shinyblink/ledstream/hw/bx-hub75/FPGA_PINS.md

# FPGA pins of the bx-hub75 board.
```
IO_1  -> OE
IO_2  -> CLK
IO_3  -> C
IO_4  -> A
IO_5  -> B2
IO_6  -> R2
IO_7  -> B1
IO_8  -> R1
IO_9  -> LAT
IO_10 -> D
IO_11 -> B
IO_12 -> E
IO_13 -> G2

IO_14 -> TX
IO_15 -> RX
IO_16 -> MOSI
IO_17 -> SCK
IO_18 -> MISO
IO_19 -> CS_EEPROM
IO_20 -> CS_EXT
IO_21 -> EXT_IO1
IO_22 -> EXT_IO2
IO_23 -> G1
IO_24 -> NC
```
