shinyblink/ledstream/hw/bx-hub75/bx-hub75.kicad_pcb

## KiCad design hw/bx-hub75/bx-hub75.kicad_pcb (2018-12-22)

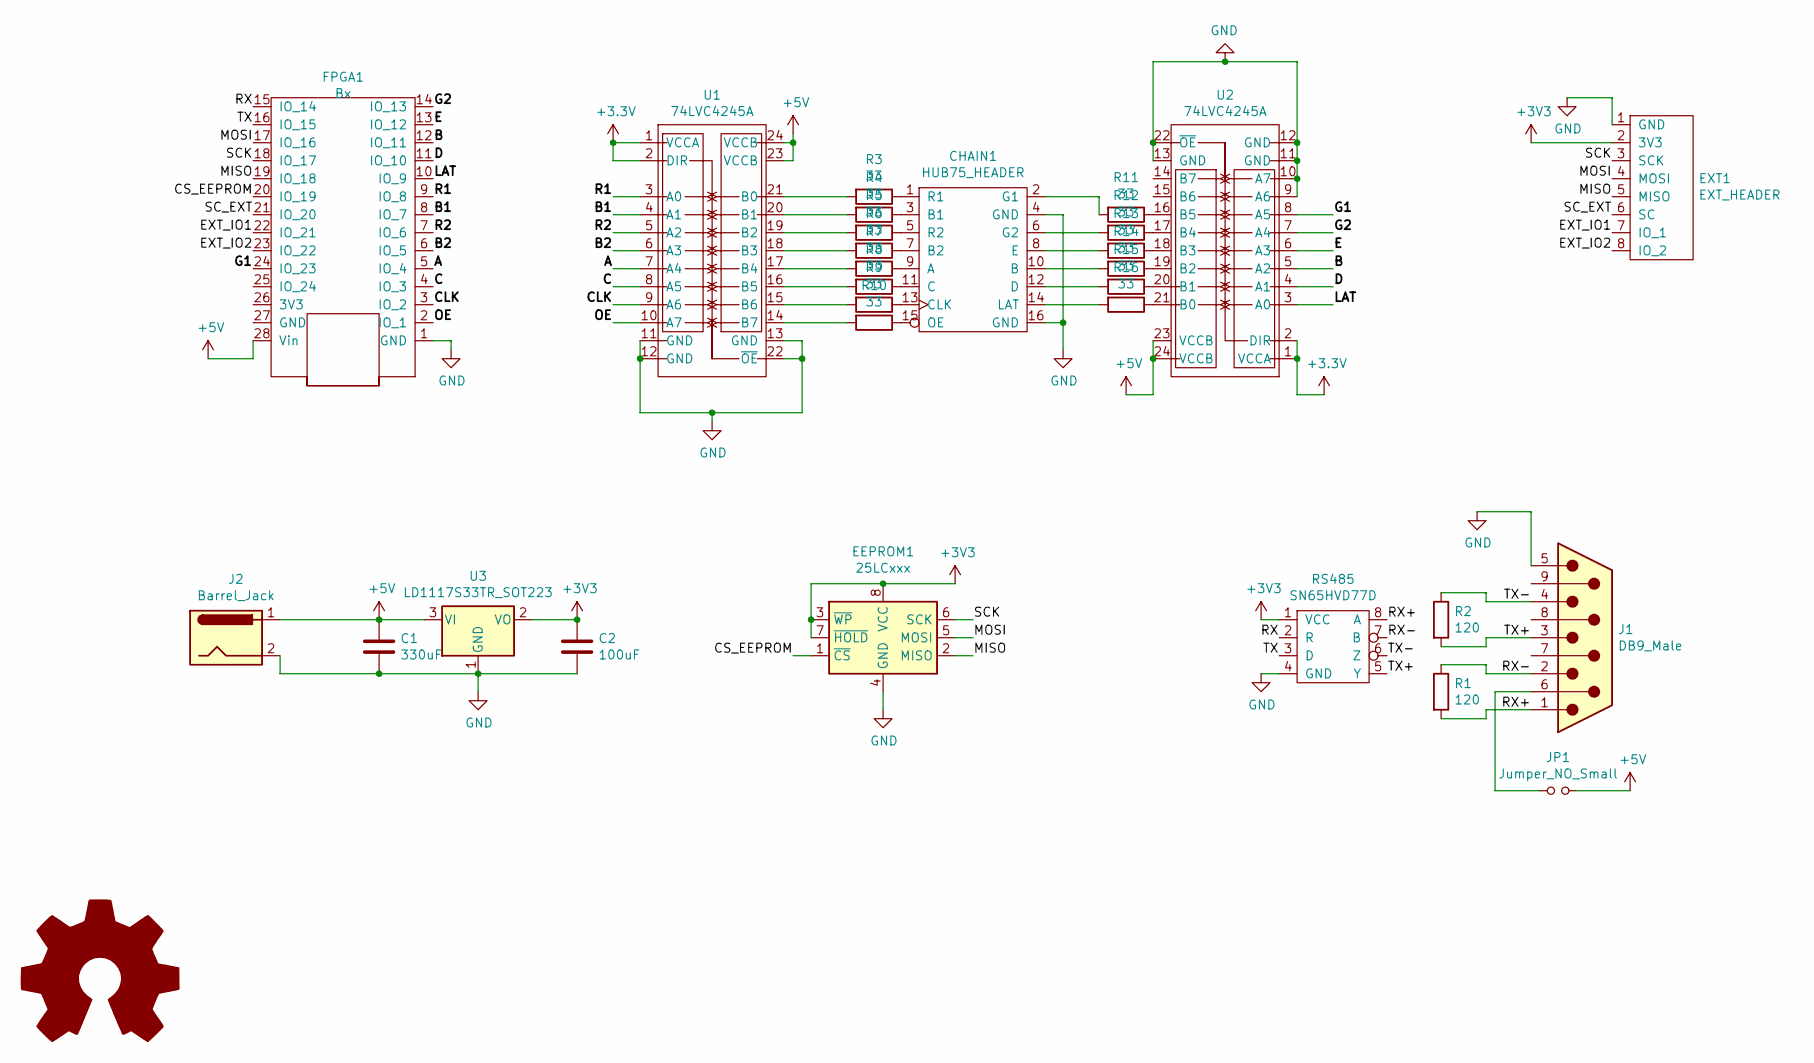
[picture p1: schematic bx-hub75.sch]

Parts:
C1: 330uF; CP_Elec_6.3x7.7
C2: 100uF; CP_Elec_5x5.4
CHAIN1: HUB75_HEADER; IDC-Header_2x08_P2.54mm_Vertical
EEPROM1: 25LCxxx; SOIC-8_3.9x4.9mm_P1.27mm
EXT1: EXT_HEADER; PinHeader_1x08_P2.54mm_Vertical
FPGA1: Bx; TinyFPGA_BX
J1: DB9_Male; DSUB-9_Male_Horizontal_P2.77x2.84mm_EdgePinOffset4.94mm_Hou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
J2: Barrel_Jack; BarrelJack_Wuerth_6941xx301002
JP1: Jumper_NO_Small; PinHeader_1x02_P2.54mm_Vertical
OSHW1: Logo_Open_Hardware_Large; OSHW-Logo2_9.8x8mm_SilkScreen
R1, R2: 120; R_1210_3225Metric_Pad1.42x2.65mm_HandSolder
R3, R4, R5, R6, R7, R8, R9, R10, R11, R12, R13, R14, R15, R16: 33; R_0805_2012Metric_Pad1.15x1.40mm_HandSolder
RS485: SN65HVD77D; SOIC-8_3.9x4.9mm_P1.27mm
U1, U2: 74LVC4245A; SOIC-24W_7.5x15.4mm_P1.27mm
U3: LD1117S33TR_SOT223; SOT-223-3_TabPin2

Connections:
+5V: C1.1, FPGA1.28 (Vin), J2.1, JP1.2, U1.23 (VCCB), U1.24 (VCCB), U2.23 (VCCB), U2.24 (VCCB), U3.3 (VI)
/A: FPGA1.5 (IO_4), U1.7 (A4)
/B: FPGA1.12 (IO_11), U2.5 (A2)
/B1: FPGA1.8 (IO_7), U1.4 (A1)
/B2: FPGA1.6 (IO_5), U1.6 (A3)
/C: FPGA1.4 (IO_3), U1.8 (A5)
/CLK: FPGA1.3 (IO_2), U1.9 (A6)
/CS_EEPROM: EEPROM1.1 (~CS), FPGA1.20 (IO_19)
/D: FPGA1.11 (IO_10), U2.4 (A1)
/E: FPGA1.13 (IO_12), U2.6 (A3)
/EXT_IO1: EXT1.7 (IO_1), FPGA1.22 (IO_21)
/EXT_IO2: EXT1.8 (IO_2), FPGA1.23 (IO_22)
/G1: FPGA1.24 (IO_23), U2.8 (A5)
/G2: FPGA1.14 (IO_13), U2.7 (A4)
/LAT: FPGA1.10 (IO_9), U2.3 (A0)
/MISO: EEPROM1.2 (MISO), EXT1.5 (MISO), FPGA1.19 (IO_18)
/MOSI: EEPROM1.5 (MOSI), EXT1.4 (MOSI), FPGA1.17 (IO_16)
/OE: FPGA1.2 (IO_1), U1.10 (A7)
/R1: FPGA1.9 (IO_8), U1.3 (A0)
/R2: FPGA1.7 (IO_6), U1.5 (A2)
/RX: FPGA1.15 (IO_14), RS485.2 (R)
/RX+: J1.1, R1.2, RS485.8 (A)
/RX-: J1.2, R1.1, RS485.7 (B)
/SCK: EEPROM1.6 (SCK), EXT1.3 (SCK), FPGA1.18 (IO_17)
/SC_EXT: EXT1.6 (SC), FPGA1.21 (IO_20)
/TX: FPGA1.16 (IO_15), RS485.3 (D)
/TX+: J1.3, R2.2, RS485.5 (Y)
/TX-: J1.4, R2.1, RS485.6 (Z)
GND: C1.2, C2.2, CHAIN1.4 (GND), CHAIN1.16 (GND), EEPROM1.4 (GND), EXT1.1 (GND), FPGA1.1 (GND), J1.5, J2.2, RS485.4 (GND), U1.11 (GND), U1.12 (GND), U1.13 (GND), U1.22 (~OE), U2.9 (A6), U2.10 (A7), U2.11 (GND), U2.12 (GND), U2.13 (GND), U2.22 (~OE), U3.1 (GND)
unnamed: CHAIN1.1 (R1), R3.1
unnamed: CHAIN1.2 (G1), R11.2
unnamed: CHAIN1.3 (B1), R4.1
unnamed: CHAIN1.5 (R2), R5.1
unnamed: CHAIN1.6 (G2), R12.2
unnamed: CHAIN1.7 (B2), R6.1
unnamed: CHAIN1.8 (E), R13.2
unnamed: CHAIN1.9 (A), R7.1
unnamed: CHAIN1.10 (B), R14.2
unnamed: CHAIN1.11 (C), R8.1
unnamed: CHAIN1.12 (D), R15.2
unnamed: CHAIN1.13 (CLK), R9.1
unnamed: CHAIN1.14 (LAT), R16.2
unnamed: CHAIN1.15 (OE), R10.1
unnamed: J1.6, JP1.1
unnamed: R3.2, U1.21 (B0)
unnamed: R4.2, U1.20 (B1)
unnamed: R5.2, U1.19 (B2)
unnamed: R6.2, U1.18 (B3)
unnamed: R7.2, U1.17 (B4)
unnamed: R8.2, U1.16 (B5)
unnamed: R9.2, U1.15 (B6)
unnamed: R10.2, U1.14 (B7)
unnamed: R11.1, U2.16 (B5)
unnamed: R12.1, U2.17 (B4)
unnamed: R13.1, U2.18 (B3)
unnamed: R14.1, U2.19 (B2)
unnamed: R15.1, U2.20 (B1)
unnamed: R16.1, U2.21 (B0)

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
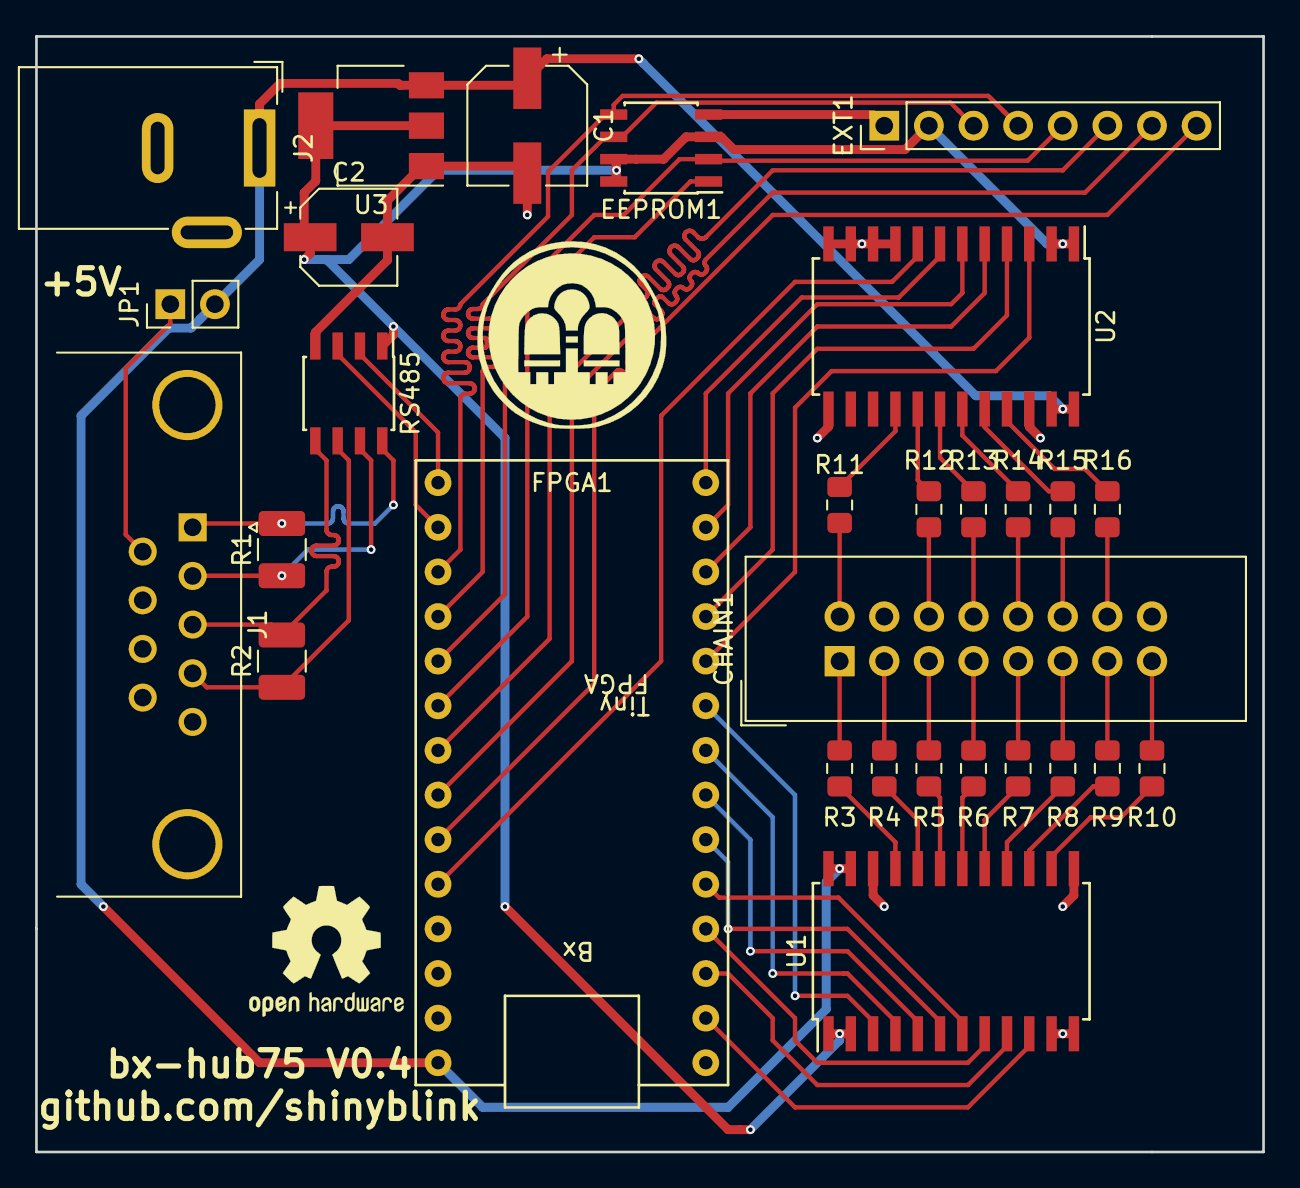
[picture p2: board bx-hub75.kicad_pcb from above]

Board: 2 copper layers, 69.8 x 63.5 mm, 30 parts (0 on the bottom side), 59 nets.
