shinyblink/ledstream/hw/rs485-breakout/rs485-breakout.kicad_pcb

## KiCad design hw/rs485-breakout/rs485-breakout.kicad_pcb (2018-12-22)

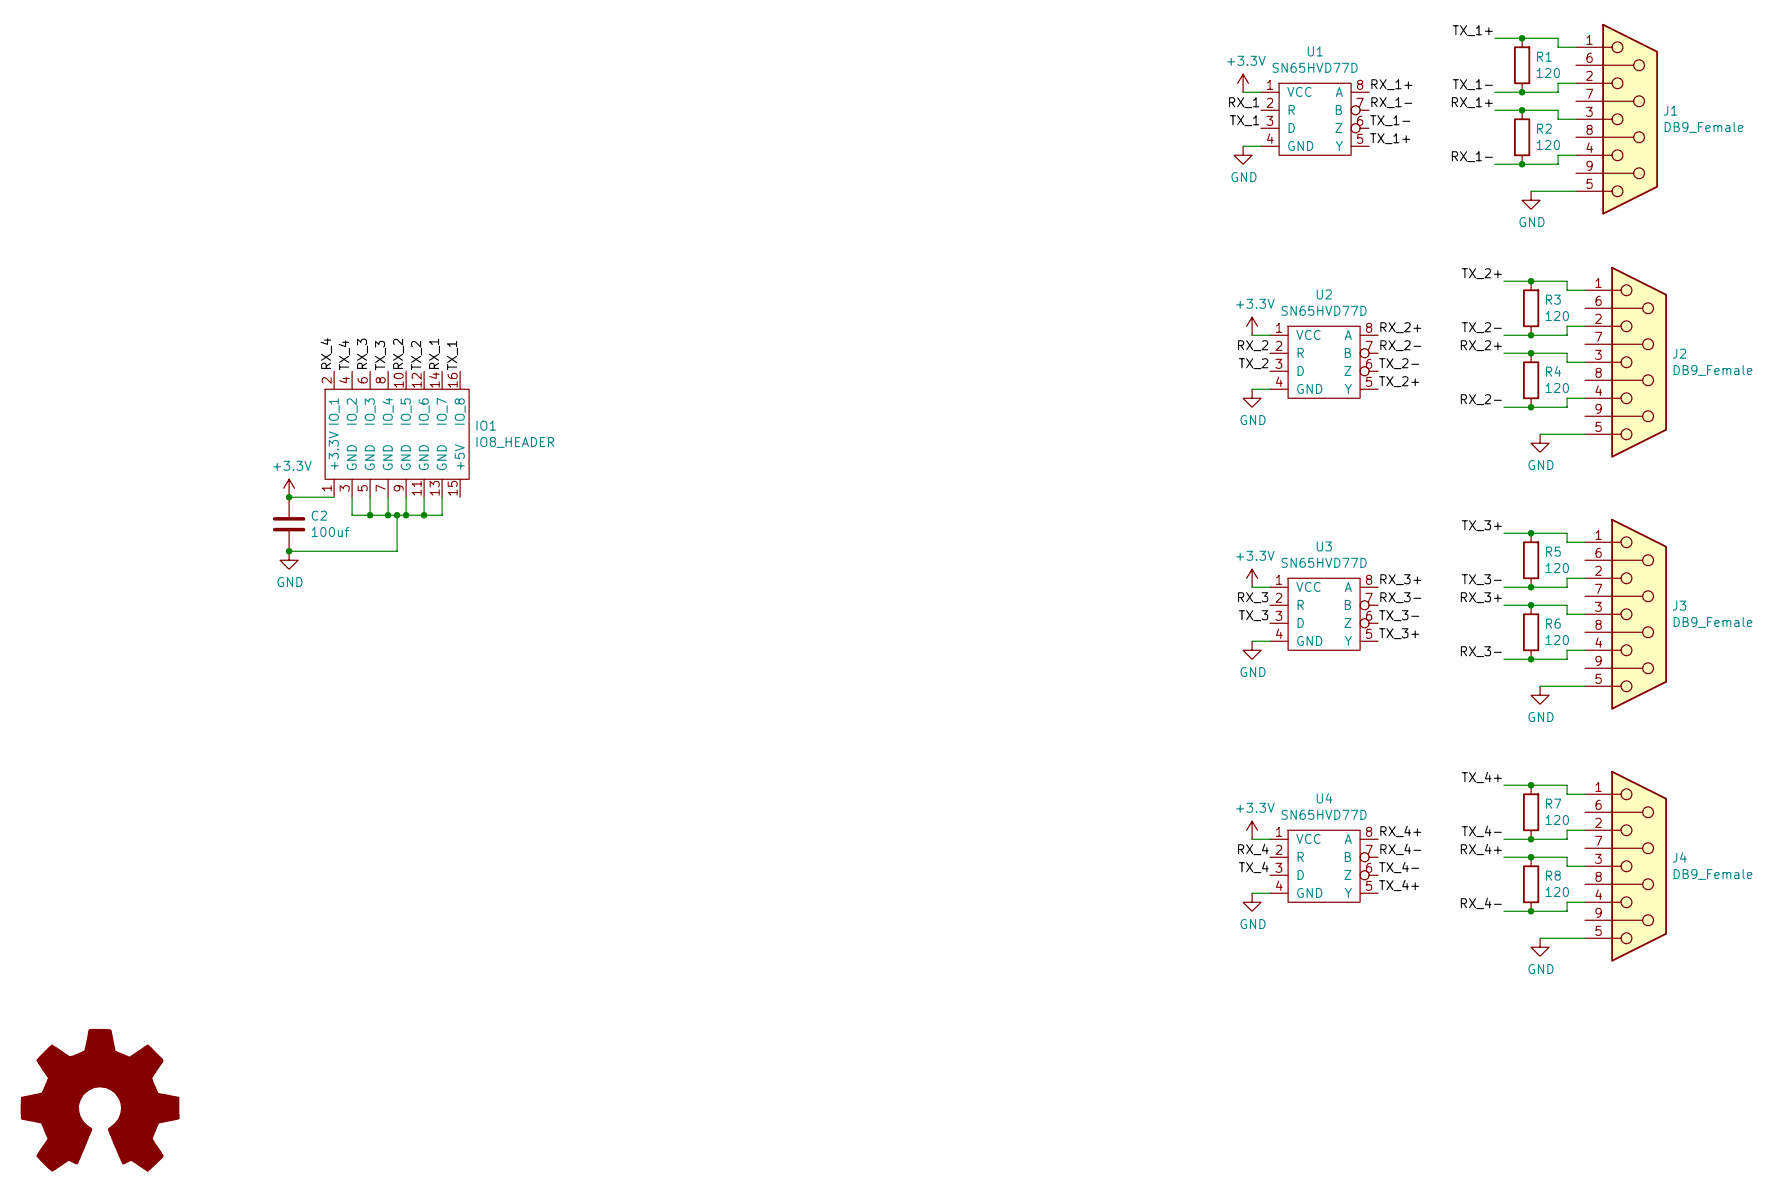
[picture p3: schematic rs485-breakout.sch]

Parts:
C2: 100uf; CP_Elec_5x5.4
IO1: IO8_HEADER; IDC-Header_2x08_P2.54mm_Vertical
J1, J2, J3, J4: DB9_Female; DSUB-9_Female_Horizontal_P2.77x2.84mm_EdgePinOffset7.70mm_H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
R1, R2, R3, R4, R5, R6, R7, R8: 120; R_1210_3225Metric_Pad1.42x2.65mm_HandSolder
U1, U2, U3, U4: SN65HVD77D; SOIC-8_3.9x4.9mm_P1.27mm

Connections:
+3V3: C2.1, IO1.1 (+3.3V), U1.1 (VCC), U2.1 (VCC), U3.1 (VCC), U4.1 (VCC)
/RX_1: IO1.14 (IO_7), U1.2 (R)
/RX_1+: J1.3, R2.1, U1.8 (A)
/RX_1-: J1.4, R2.2, U1.7 (B)
/RX_2: IO1.10 (IO_5), U2.2 (R)
/RX_2+: J2.3, R4.1, U2.8 (A)
/RX_2-: J2.4, R4.2, U2.7 (B)
/RX_3: IO1.6 (IO_3), U3.2 (R)
/RX_3+: J3.3, R6.1, U3.8 (A)
/RX_3-: J3.4, R6.2, U3.7 (B)
/RX_4: IO1.2 (IO_1), U4.2 (R)
/RX_4+: J4.3, R8.1, U4.8 (A)
/RX_4-: J4.4, R8.2, U4.7 (B)
/TX_1: IO1.16 (IO_8), U1.3 (D)
/TX_1+: J1.1, R1.2, U1.5 (Y)
/TX_1-: J1.2, R1.1, U1.6 (Z)
/TX_2: IO1.12 (IO_6), U2.3 (D)
/TX_2+: J2.1, R3.2, U2.5 (Y)
/TX_2-: J2.2, R3.1, U2.6 (Z)
/TX_3: IO1.8 (IO_4), U3.3 (D)
/TX_3+: J3.1, R5.2, U3.5 (Y)
/TX_3-: J3.2, R5.1, U3.6 (Z)
/TX_4: IO1.4 (IO_2), U4.3 (D)
/TX_4+: J4.1, R7.2, U4.5 (Y)
/TX_4-: J4.2, R7.1, U4.6 (Z)
GND: C2.2, IO1.3 (GND), IO1.5 (GND), IO1.7 (GND), IO1.9 (GND), IO1.11 (GND), IO1.13 (GND), J1.5, J2.5, J3.5, J4.5, U1.4 (GND), U2.4 (GND), U3.4 (GND), U4.4 (GND)

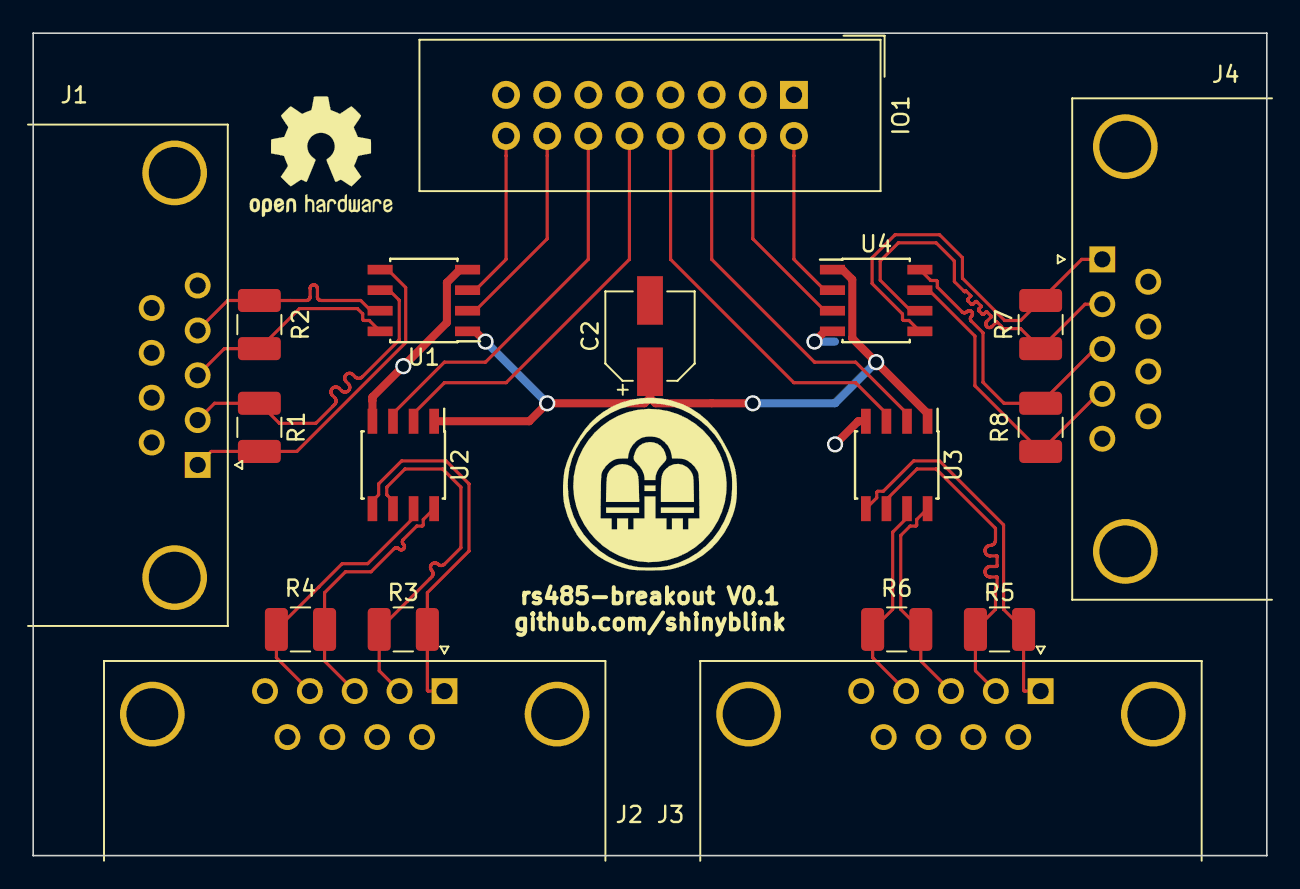
[picture p4: board rs485-breakout.kicad_pcb from above]

Board: 2 copper layers, 76.2 x 50.8 mm, 18 parts (0 on the bottom side), 26 nets.
