shinyblink/ledstream/hw/bx-pihat/bx-pihat.kicad_pcb

## KiCad design hw/bx-pihat/bx-pihat.kicad_pcb (2018-12-22)

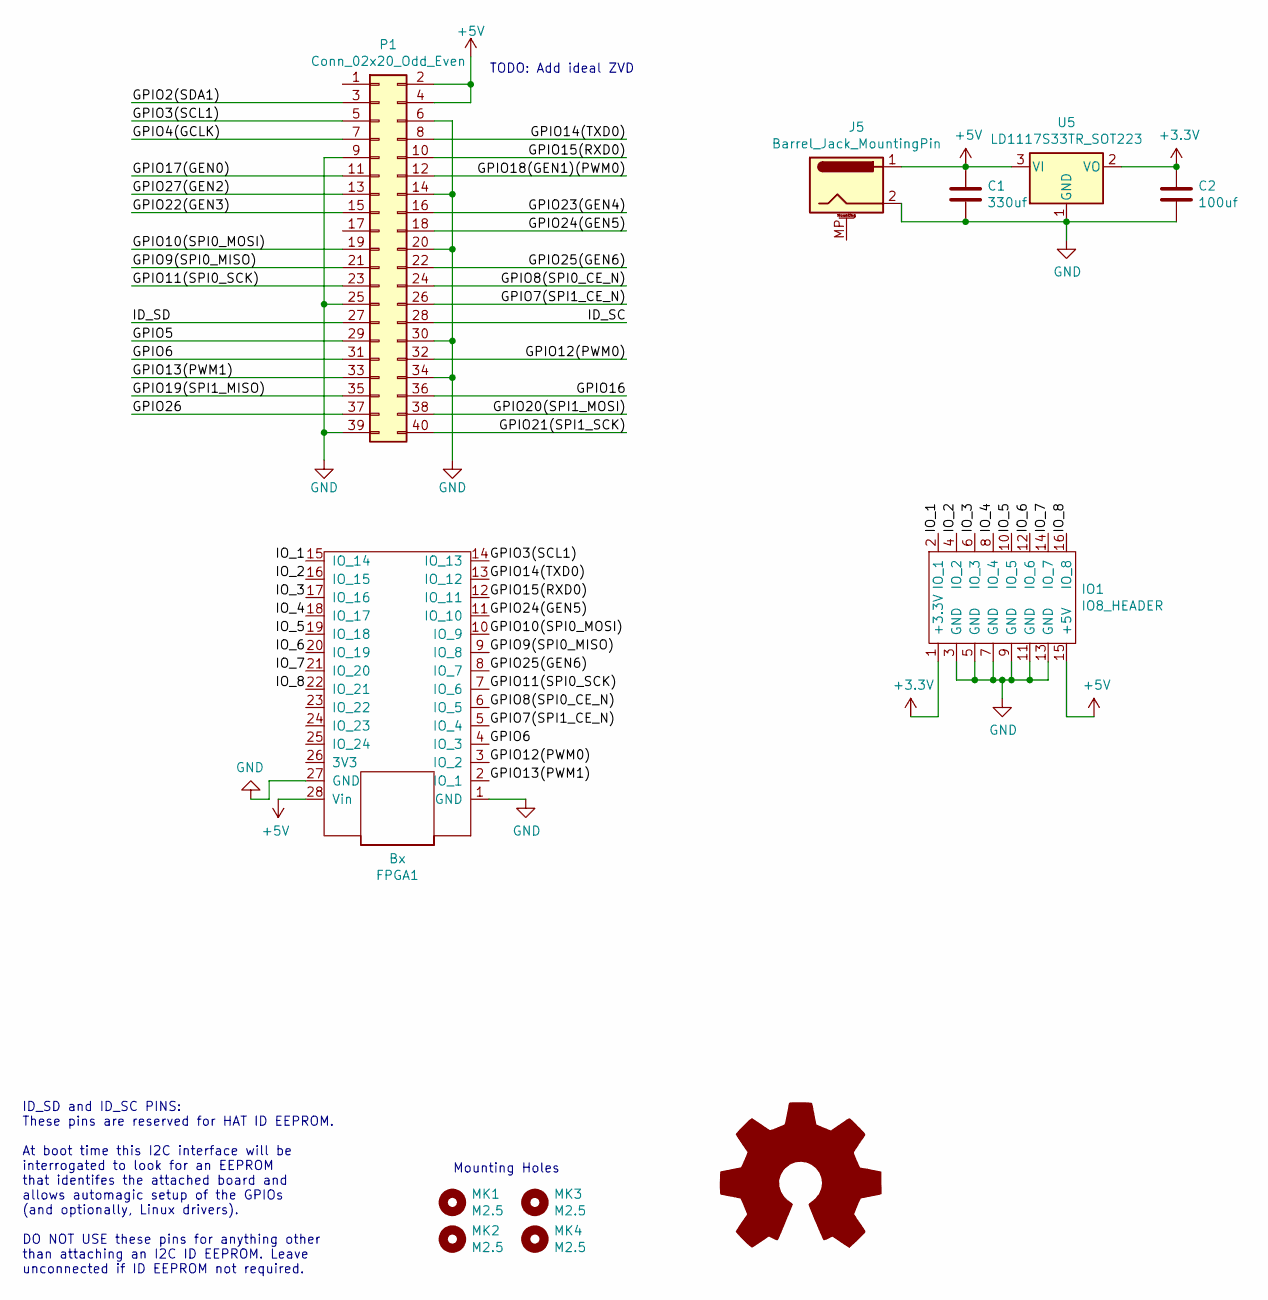
[picture p5: schematic bx-pihat.sch]

Parts:
C1: 330uf; CP_Elec_6.3x7.7
C2: 100uf; CP_Elec_5x5.4
FPGA1: Bx; TinyFPGA_BX
IO1: IO8_HEADER; IDC-Header_2x08_P2.54mm_Vertical
J5: Barrel_Jack_MountingPin; BarrelJack_Wuerth_6941xx301002
MK1, MK2, MK3, MK4: M2.5; MountingHole_2.7mm_M2.5
P1: Conn_02x20_Odd_Even; PinSocket_2x20_P2.54mm_Vertical
U5: LD1117S33TR_SOT223; SOT-223-3_TabPin2

Connections:
+3V3: C2.1, IO1.1 (+3.3V), U5.2 (VO)
+5V: C1.1, FPGA1.28 (Vin), IO1.15 (+5V), J5.1, P1.2, P1.4, U5.3 (VI)
/GPIO2(SDA1): P1.3
/GPIO3(SCL1): FPGA1.14 (IO_13), P1.5
/GPIO4(GCLK): P1.7
/GPIO5: P1.29
/GPIO6: FPGA1.4 (IO_3), P1.31
/GPIO7(SPI1_CE_N): FPGA1.5 (IO_4), P1.26
/GPIO8(SPI0_CE_N): FPGA1.6 (IO_5), P1.24
/GPIO9(SPI0_MISO): FPGA1.9 (IO_8), P1.21
/GPIO10(SPI0_MOSI): FPGA1.10 (IO_9), P1.19
/GPIO11(SPI0_SCK): FPGA1.7 (IO_6), P1.23
/GPIO12(PWM0): FPGA1.3 (IO_2), P1.32
/GPIO13(PWM1): FPGA1.2 (IO_1), P1.33
/GPIO14(TXD0): FPGA1.13 (IO_12), P1.8
/GPIO15(RXD0): FPGA1.12 (IO_11), P1.10
/GPIO16: P1.36
/GPIO17(GEN0): P1.11
/GPIO18(GEN1)(PWM0): P1.12
/GPIO19(SPI1_MISO): P1.35
/GPIO20(SPI1_MOSI): P1.38
/GPIO21(SPI1_SCK): P1.40
/GPIO22(GEN3): P1.15
/GPIO23(GEN4): P1.16
/GPIO24(GEN5): FPGA1.11 (IO_10), P1.18
/GPIO25(GEN6): FPGA1.8 (IO_7), P1.22
/GPIO26: P1.37
/GPIO27(GEN2): P1.13
/ID_SC: P1.28
/ID_SD: P1.27
/IO_1: FPGA1.15 (IO_14), IO1.2 (IO_1)
/IO_2: FPGA1.16 (IO_15), IO1.4 (IO_2)
/IO_3: FPGA1.17 (IO_16), IO1.6 (IO_3)
/IO_4: FPGA1.18 (IO_17), IO1.8 (IO_4)
/IO_5: FPGA1.19 (IO_18), IO1.10 (IO_5)
/IO_6: FPGA1.20 (IO_19), IO1.12 (IO_6)
/IO_7: FPGA1.21 (IO_20), IO1.14 (IO_7)
/IO_8: FPGA1.22 (IO_21), IO1.16 (IO_8)
GND: C1.2, C2.2, FPGA1.1 (GND), FPGA1.27 (GND), IO1.3 (GND), IO1.5 (GND), IO1.7 (GND), IO1.9 (GND), IO1.11 (GND), IO1.13 (GND), J5.2, P1.6, P1.9, P1.14, P1.20, P1.25, P1.30, P1.34, P1.39, U5.1 (GND)

Notes on the sheet:
ID_SD and ID_SC PINS: These pins are reserved for HAT ID EEPROM. At boot time this I2C interface will be interrogated to look for an EEPROM that identifes the attached board and allows automagic setup of the GPIOs (and optionally, Linux drivers). DO NOT USE these pins for anything other than attach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
Mounting Holes
TODO: Add ideal ZVD

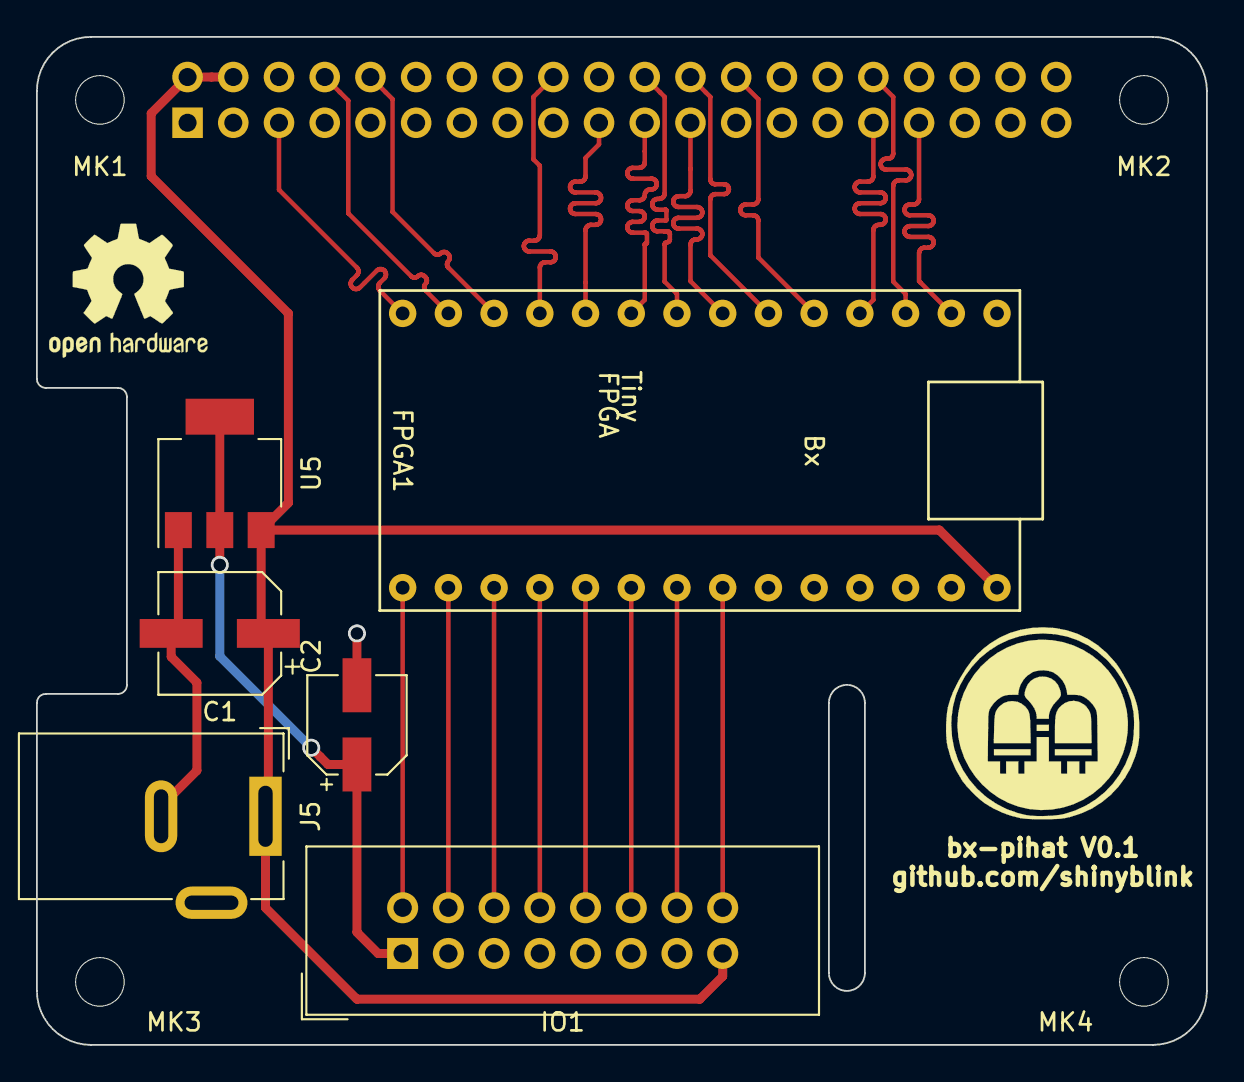
[picture p6: board bx-pihat.kicad_pcb from above]

Board: 2 copper layers, 65.0 x 56.0 mm, 11 parts (1 on the bottom side), 24 nets.
