shinyblink/ledstream/(commit log)

2018-11-14 Epoch.
    It all starts with a single footprint. And a symbol.
    [bx-hub75.kicad_pcb, bx-hub75.sch]
2018-11-14 hw/bx-hub75: hook up HUB75 to line drivers.
    [bx-hub75.sch]
2018-11-15 hw/bx-hub75: hook up RS485 and line drivers to FPGA.
    [bx-hub75.sch]
2018-11-18 hw/bx-hub75: 3.3V VREG
    [bx-hub75.sch]
2018-11-19 hw/bx-hub75: add SPI eeprom/decoupling caps
    [bx-hub75.sch]
2018-11-19 hw/bx-hub75: Initial PCB layout.
    God, routing this is complex.
    [bx-hub75.kicad_pcb, bx-hub75.sch]
2018-11-19 hw/bx-hub75: 74HCT244 -> 74HCT541
    [bx-hub75.kicad_pcb, bx-hub75.sch]
2018-11-20 hw/bx-hub75: finish basic routing.
    [bx-hub75.kicad_pcb, bx-hub75.sch]
2018-11-21 hw/{library,bx-hub75}: TinyFPGA has 28 pins, not 26...
    [bx-hub75.kicad_pcb, bx-hub75.sch]
2018-11-26 hw/bx-hub75: oshw logo, text, extension header
    [bx-hub75.kicad_pcb, bx-hub75.sch]
2018-11-26 hw/bx-hub75: add barrel jack
    [bx-hub75.kicad_pcb, bx-hub75.sch]
2018-11-29 hw: Add gerber generation script/Makefile
2018-11-29 hw/bx-hub75: reroute to 0.1m minimum trace spacing
    [bx-hub75.kicad_pcb]
2018-12-01 hw/bx-hub75: allow bom generation with kibom
    [bx-hub75.kicad_pcb, bx-hub75.sch]
2018-12-07 hw/bx-hub75: V0.2 PCB/SCH.
    [bx-hub75.kicad_pcb, bx-hub75.sch]
2018-12-10 hw/bx-hub75: v0.3, E Line support.
    [bx-hub75.kicad_pcb, bx-hub75.sch]
2018-12-13 sw/bx-smitest: Add Verilog Raspberry PI SMI driver.
    Probably not working, but it's a start.
    [bx-smitest.v, smi.v]
2018-12-13 sw/bx-smitest: fix asynchronous OE/WE not always registering
    [smi.v]
2018-12-16 sw/*: WIP HUB75 driver.
    In theory, this does 1bit output on HUB75 panels, with N cycles of latency inbetween. Many thanks to @kbob for his code, from which I took a lot of inspiration.
2018-12-16 sw/etc1: improve testbench, fix wrong bit width of etc1_decode x/y inputs
    [etc1.v, etc1_tb.v]
2018-12-16 sw/bx-hub75test: add hub75 testing, its broken.
    [bx-hub75test.v, hub75.v]
2018-12-16 sw/bx-hub75test: wire order?
2018-12-17 sw/bx-hub75test: fix more issues.
    [bx-hub75test.v, hub75.v]
2018-12-17 sw/bx-hub75test: Fix typos. Thanks @gregdavill.
    I was looking at hub75_driver the whole time, thank you.
    [hub75.v]
2018-12-22 hw/bx-pihat: add v0.1.
    [bx-pictl.kicad_pcb, bx-pictl.sch, bx-pihat.kicad_pcb, bx-pihat.sch]
2018-12-22 hw/rs485-breakout: add V0.1
    [rs485-breakout.kicad_pcb, rs485-breakout.sch]
2018-12-22 hw/bx-hub75: release V0.4.
    [bx-hub75.kicad_pcb, bx-hub75.sch, bx-pictl.kicad_pcb, bx-pictl.sch, rs485-breakout.sch]
